Ironman-007/SensorNet_Host/Reference/PCB/nets_v2.brd

## EAGLE design Reference/PCB/nets_v2.brd (2024-06-01)

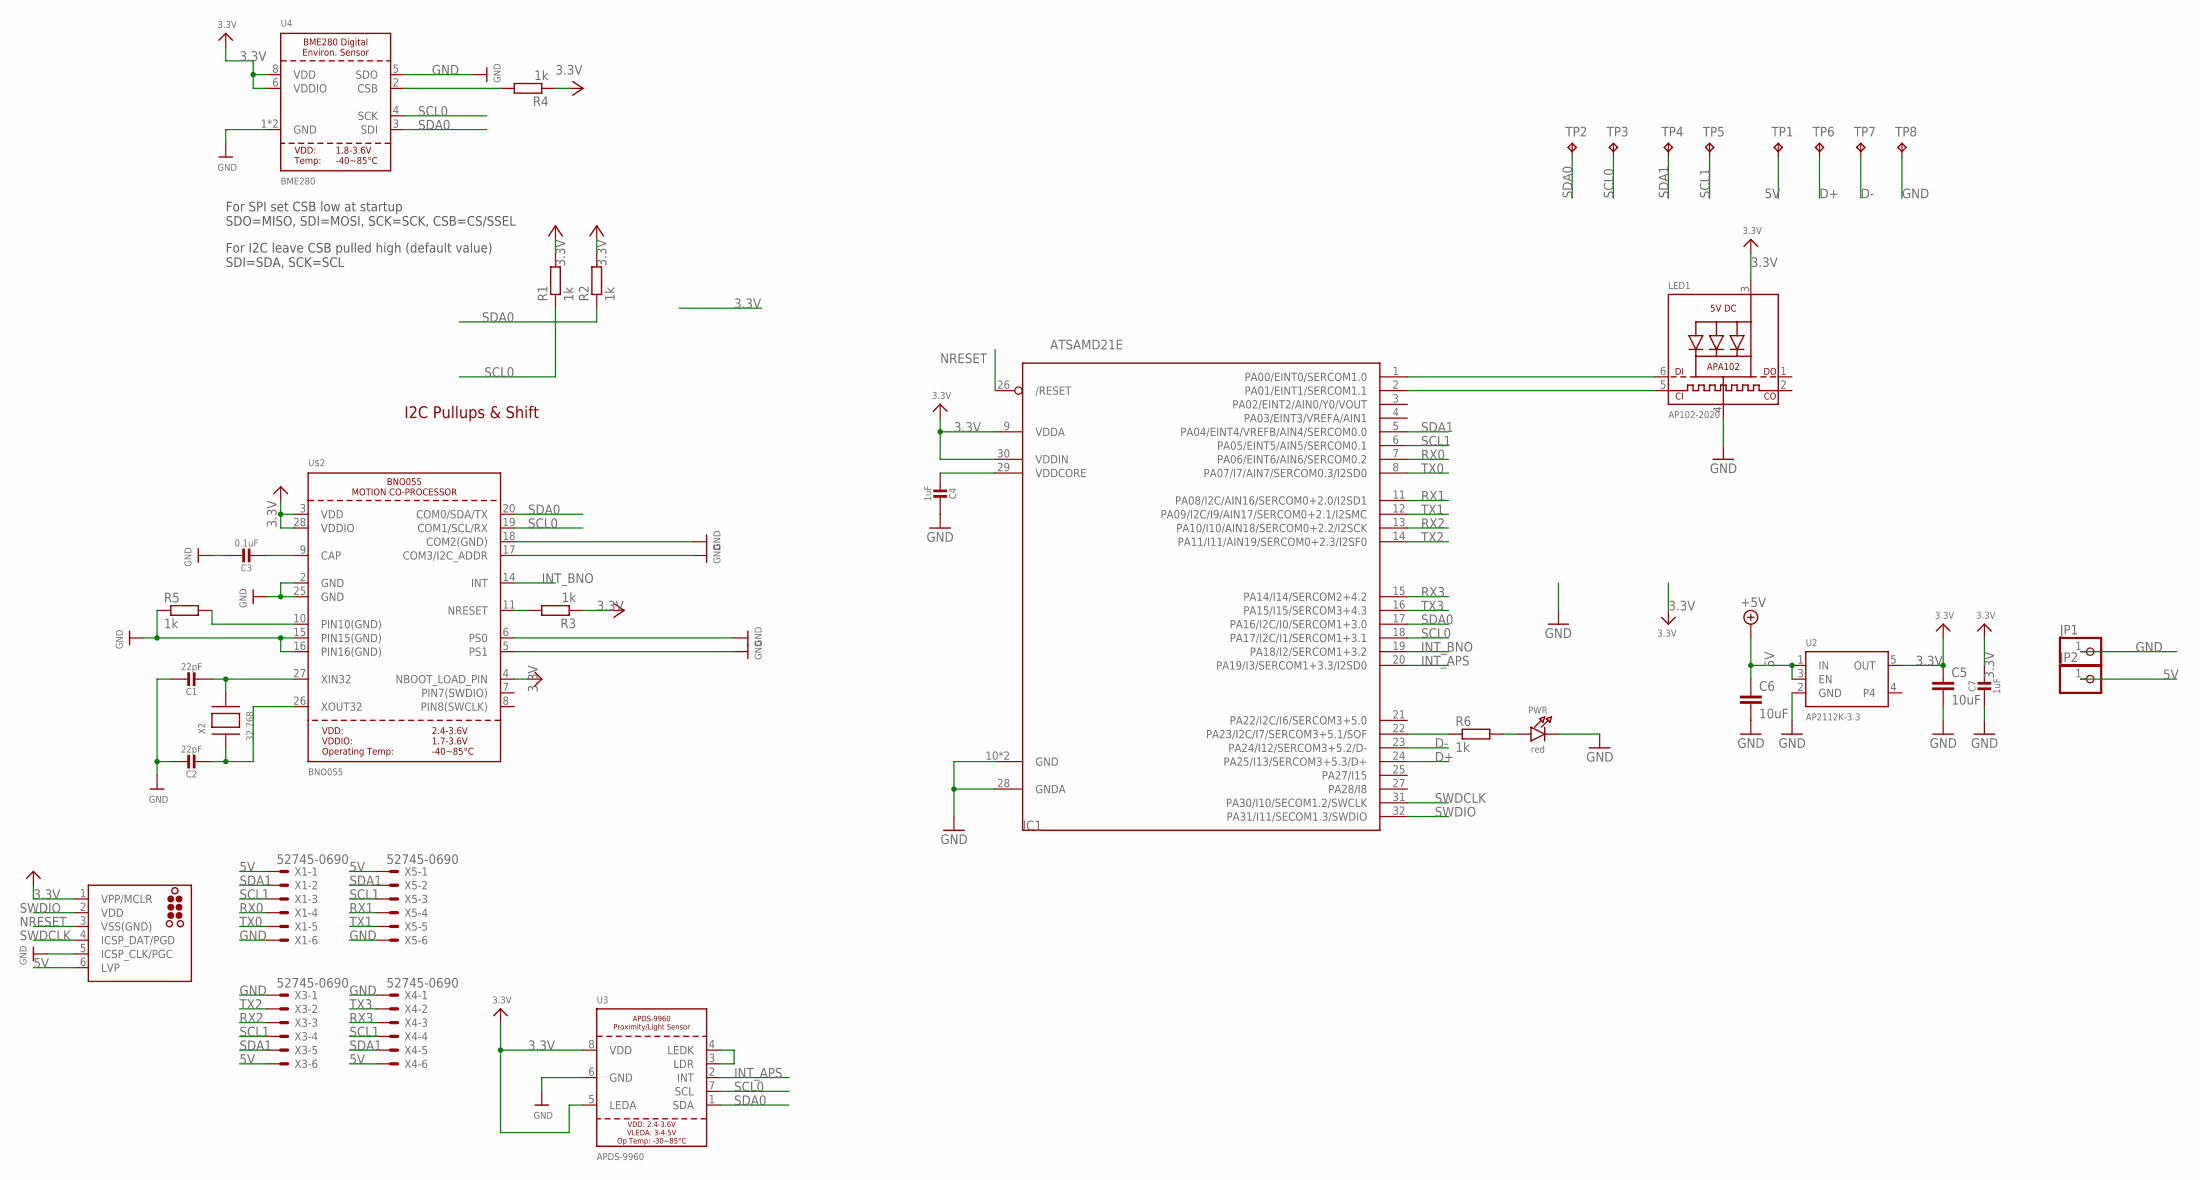
[picture p1: schematic nets_v2.sch]

Parts:
C1, C2: 22pF; _0402NO; MPN 885012005042
C3: 0.1uF; _0402NO; MPN R79IC3100Z340J
C4, C7: 1uF; _0402NO
C5, C6: 10uF; C0603
IC1: ATSAMD21E; QFN32_5MM
J1: TC2030-ICSP-MCP-NL; TC2030-MCP-NL
JP1, JP2: PINHD-1X1; 1X01
LED1: AP102-2020; APA102_2020
PWR: red; CHIPLED_0603_NOOUTLINE
R1, R2, R3, R4, R5, R6: 1k; R0402
TP1, TP2, TP3, TP4, TP5, TP6, TP7, TP8: TPTP10R; TP10R
U2: AP2112K-3.3; SOT23-5
U3: APDS-9960
U4: BME280
U$2: BNO055
X1, X3, X4, X5: 52745-0690
X2: 32.768; XTAL3215

Connections:
3.3V: C5.1, C7.1, IC1.9 (VDDA), IC1.30 (VDDIN), J1.1 (VPP/MCLR), LED1.3 (VDD), R1.2, R2.2, R3.1, R4.1, U2.5 (OUT), U3.5 (LEDA), U3.8 (VDD), U4.6 (VDDIO), U4.8 (VDD), U$2.3 (VDD), U$2.4 (NBOOT_LOAD_PIN), U$2.28 (VDDIO)
5V: C6.1, J1.6 (LVP), JP2.1, TP1.TP, U2.1 (IN), U2.3 (EN), X1.1, X3.6, X4.6, X5.1
D+: IC1.24 (PA25/I13/SERCOM3+5.3/D+), TP6.TP
D-: IC1.23 (PA24/I12/SERCOM3+5.2/D-), TP7.TP
GND: C1.1, C2.1, C3.1, C4.1, C5.2, C6.2, C7.2, IC1.10 (GND), IC1.28 (GNDA), IC1.33 (GND), J1.5 (ICSP_CLK/PGC), JP1.1, LED1.4 (GND), PWR.C, R5.1, TP8.TP, U2.2 (GND), U3.6 (GND), U4.1 (GND), U4.5 (SDO), U4.7 (GND), U$2.2 (GND), U$2.5 (PS1), U$2.6 (PS0), U$2.15 (PIN15(GND)), U$2.16 (PIN16(GND)), U$2.17 (COM3/I2C_ADDR), U$2.18 (COM2(GND)), U$2.25 (GND), X1.6, X3.1, X4.1, X5.6
INT_APS: IC1.20 (PA19/I3/SERCOM1+3.3/I2SD0), U3.2 (INT)
INT_BNO: IC1.19 (PA18/I2/SERCOM1+3.2), U$2.14 (INT)
unnamed: C1.2, U$2.27 (XIN32), X2.P$2
unnamed: C2.2, U$2.26 (XOUT32), X2.P$1
unnamed: C3.2, U$2.9 (CAP)
unnamed: PWR.A, R6.2
unnamed: U3.3 (LDR), U3.4 (LEDK)
unnamed: R5.2, U$2.10 (PIN10(GND))
unnamed: R3.2, U$2.11 (NRESET)
unnamed: R4.2, U4.2 (CSB)
unnamed: IC1.1 (PA00/EINT0/SERCOM1.0), LED1.6 (DI)
unnamed: IC1.22 (PA23/I2C/I7/SERCOM3+5.1/SOF), R6.1
unnamed: IC1.2 (PA01/EINT1/SERCOM1.1), LED1.5 (CKI)
NRESET: IC1.26 (/RESET), J1.3 (VSS(GND))
RX0: IC1.7 (PA06/EINT6/AIN6/SERCOM0.2), X1.4
RX1: IC1.11 (PA08/I2C/AIN16/SERCOM0+2.0/I2SD1), X5.4
RX2: IC1.13 (PA10/I10/AIN18/SERCOM0+2.2/I2SCK), X3.3
RX3: IC1.15 (PA14/I14/SERCOM2+4.2), X4.3
SCL0: IC1.18 (PA17/I2C/I1/SERCOM1+3.1), R1.1, TP3.TP, U3.7 (SCL), U4.4 (SCK), U$2.19 (COM1/SCL/RX)
SCL1: IC1.6 (PA05/EINT5/AIN5/SERCOM0.1), TP5.TP, X1.3, X3.4, X4.4, X5.3
SDA0: IC1.17 (PA16/I2C/I0/SERCOM1+3.0), R2.1, TP2.TP, U3.1 (SDA), U4.3 (SDI), U$2.20 (COM0/SDA/TX)
SDA1: IC1.5 (PA04/EINT4/VREFB/AIN4/SERCOM0.0), TP4.TP, X1.2, X3.5, X4.5, X5.2
SWDCLK: IC1.31 (PA30/I10/SECOM1.2/SWCLK), J1.4 (ICSP_DAT/PGD)
SWDIO: IC1.32 (PA31/I11/SECOM1.3/SWDIO), J1.2 (VDD)
TX0: IC1.8 (PA07/I7/AIN7/SERCOM0.3/I2SD0), X1.5
TX1: IC1.12 (PA09/I2C/I9/AIN17/SERCOM0+2.1/I2SMC), X5.5
TX2: IC1.14 (PA11/I11/AIN19/SERCOM0+2.3/I2SF0), X3.2
TX3: IC1.16 (PA15/I15/SERCOM3+4.3), X4.2
VDDCORE: C4.2, IC1.29 (VDDCORE)

Notes on the sheet:
I2C Pullups & Shift
For SPI set CSB low at startup SDO=MISO, SDI=MOSI, SCK=SCK, CSB=CS/SSEL
For I2C leave CSB pulled high (default value) SDI=SDA, SCK=SCL

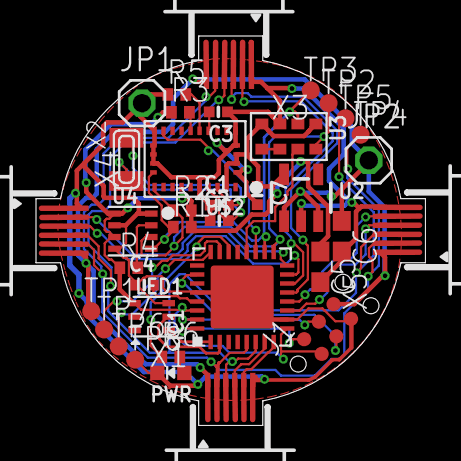
[picture p2: board nets_v2.brd from above]

Board: 2 copper layers, 21.6 x 21.6 mm, 36 parts (0 on the bottom side), 34 nets.
