Ironman-007/SensorNet_Host/Reference/PCB/nets_v3_mastersmall.brd

## EAGLE design Reference/PCB/nets_v3_mastersmall.brd (2024-06-01)

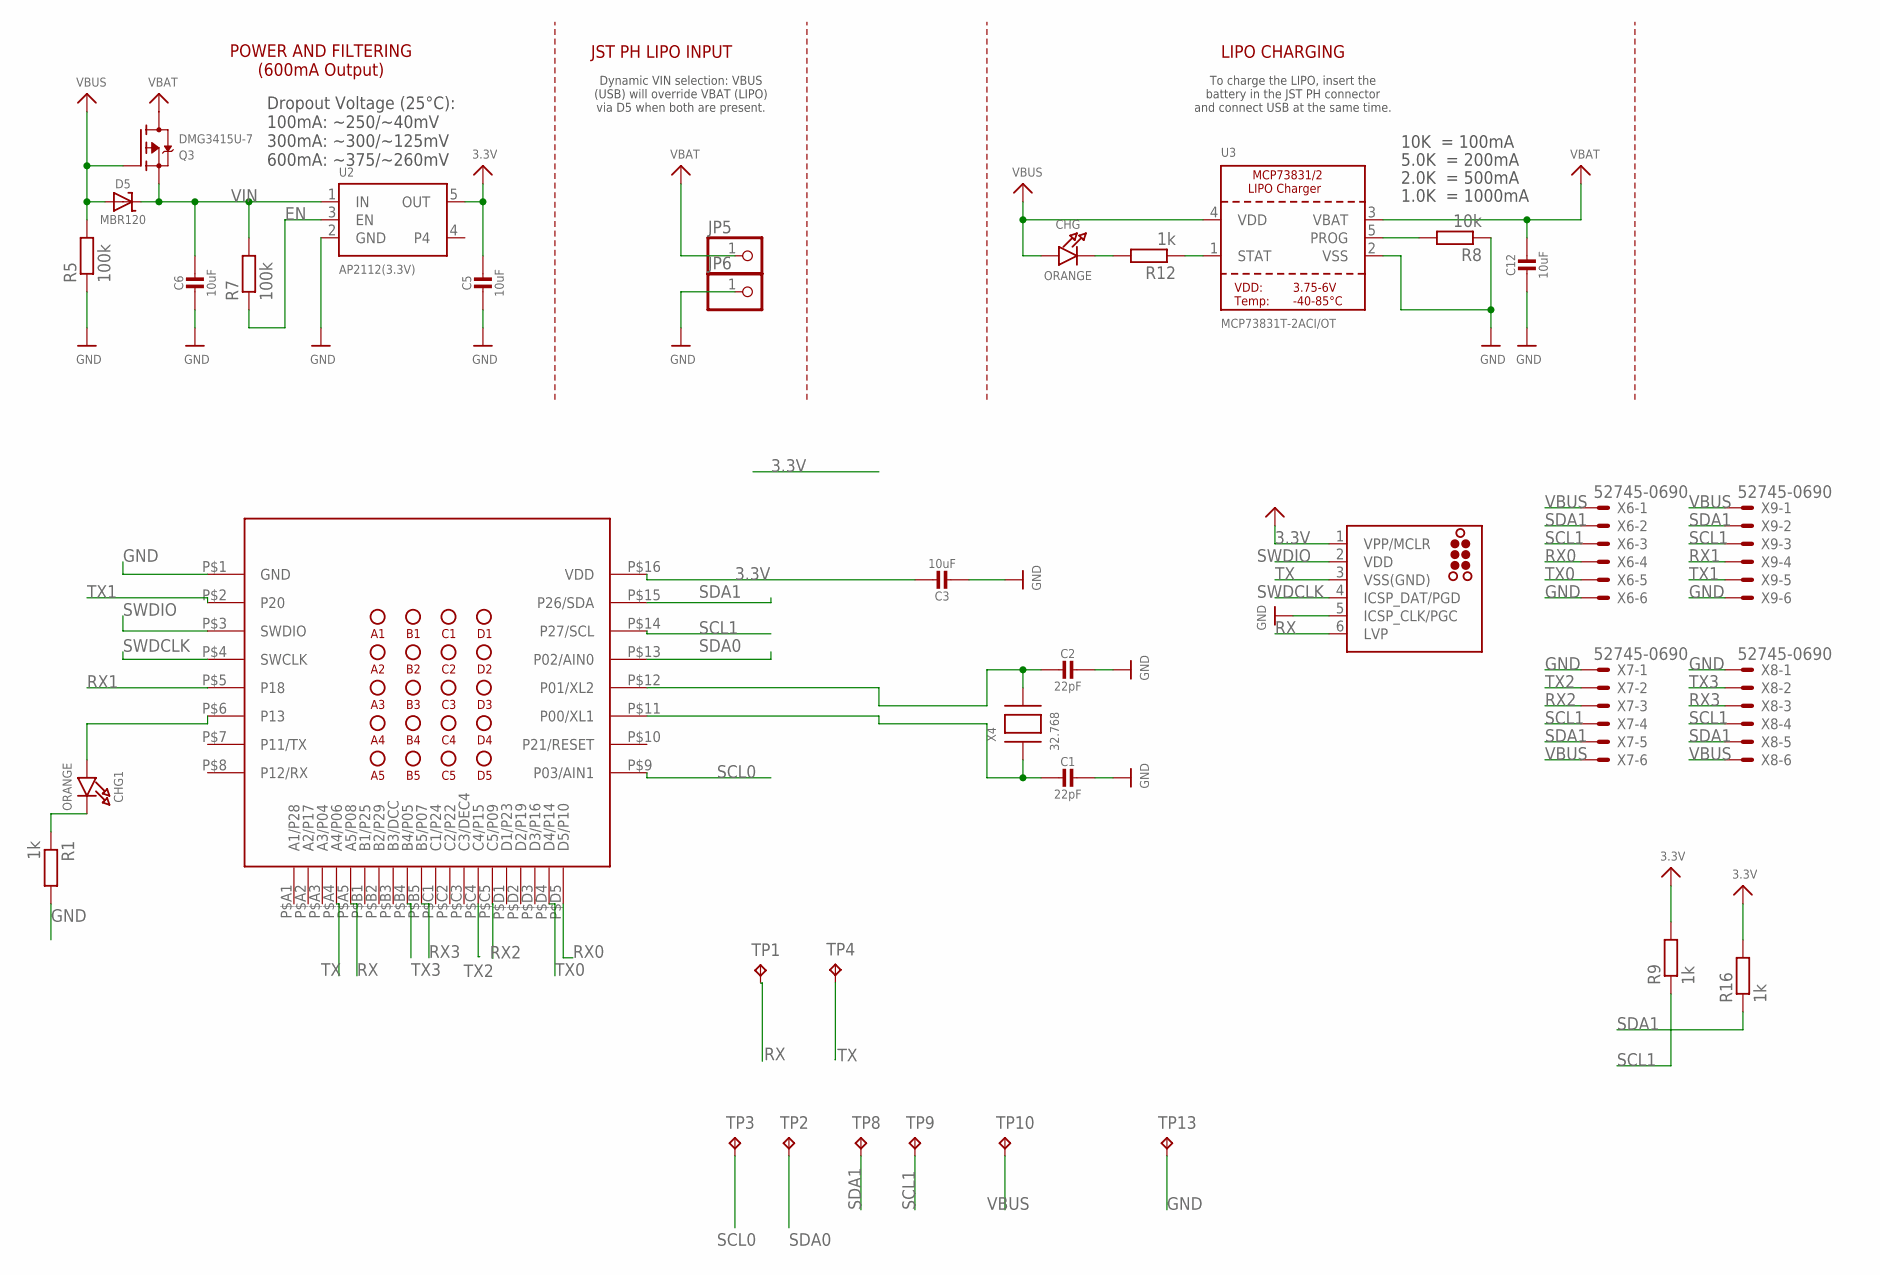
[picture p3: schematic nets_v3_mastersmall.sch]

Parts:
C1, C2: 22pF; _0402NO; MPN 885012005042
C3, C5, C6, C12: 10uF; 0603-NO
CHG, CHG1: ORANGE; CHIPLED_0805_NOOUTLINE
D5: MBR120; SOD-123
J1: TC2030-ICSP-MCP-NL; TC2030-MCP-NL
JP5, JP6: PINHD-1X1; 1X01
Q3: DMG3415U-7; SOT23-R
R1, R9, R12, R16: 1k; R0402
R5, R7: 100k; R0402
R8: 10k; R0402
TP1, TP2, TP3, TP4, TP8, TP9, TP10, TP13: TPTP10R; TP10R
U1: BC832-V1; BC832
U2: AP2112(3.3V); SOT23-5
U3: MCP73831T-2ACI/OT; SOT23-5
X4: 32.768; XTAL3215
X6, X7, X8, X9: 52745-0690

Connections:
3.3V: C3.1, C5.1, J1.1 (VPP/MCLR), R9.2, R16.2, U1.P$16 (VDD), U2.5 (OUT)
EN: R7.1, U2.3 (EN)
GND: C1.1, C2.1, C3.2, C5.2, C6.2, C12.2, J1.5 (ICSP_CLK/PGC), JP6.1, R1.2, R5.1, R8.1, TP13.TP, U1.P$1 (GND), U2.2 (GND), U3.2 (VSS), X6.6, X7.1, X8.1, X9.6
unnamed: CHG.C, R12.2
unnamed: C1.2, U1.P$11 (P00/XL1), X4.P$1
unnamed: CHG1.A, U1.P$6 (P13)
unnamed: CHG1.C, R1.1
unnamed: C2.2, U1.P$12 (P01/XL2), X4.P$2
unnamed: R12.1, U3.1 (STAT)
unnamed: R8.2, U3.5 (PROG)
RX: J1.6 (LVP), TP1.TP, U1.P$A5 (A5/P08)
RX0: U1.P$D5 (D5/P10), X6.4
RX1: U1.P$5 (P18), X9.4
RX2: U1.P$C5 (C5/P09), X7.3
RX3: U1.P$B5 (B5/P07), X8.3
SCL0: TP3.TP, U1.P$9 (P03/AIN1)
SCL1: R9.1, TP9.TP, U1.P$14 (P27/SCL), X6.3, X7.4, X8.4, X9.3
SDA0: TP2.TP, U1.P$13 (P02/AIN0)
SDA1: R16.1, TP8.TP, U1.P$15 (P26/SDA), X6.2, X7.5, X8.5, X9.2
SWDCLK: J1.4 (ICSP_DAT/PGD), U1.P$4 (SWCLK)
SWDIO: J1.2 (VDD), U1.P$3 (SWDIO)
TX: J1.3 (VSS(GND)), TP4.TP, U1.P$A4 (A4/P06)
TX0: U1.P$D4 (D4/P14), X6.5
TX1: U1.P$2 (P20), X9.5
TX2: U1.P$C4 (C4/P15), X7.2
TX3: U1.P$B4 (B4/P05), X8.2
VBAT: C12.1, JP5.1, Q3.3 (D), U3.3 (VBAT)
VBUS: CHG.A, D5.A, Q3.1 (G), R5.2, TP10.TP, U3.4 (VDD), X6.1, X7.6, X8.6, X9.1
VIN: C6.1, D5.C, Q3.2 (S), R7.2, U2.1 (IN)

Notes on the sheet:
10K = 100mA
5.0K = 200mA
2.0K = 500mA
1.0K = 1000mA
LIPO CHARGING
To charge the LIPO, insert the battery in the JST PH connector and connect USB at the same time.
POWER AND FILTERING (600mA Output)
JST PH LIPO INPUT
Dynamic VIN selection: VBUS (USB) will override VBAT (LIPO) via D5 when both are present.
Dropout Voltage (25°C): 100mA: ~250/~40mV 300mA: ~300/~125mV 600mA: ~375/~260mV

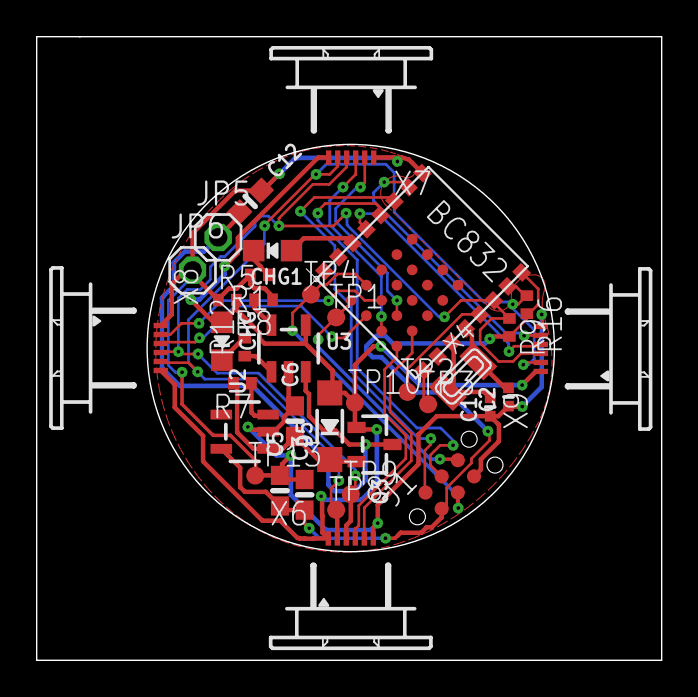
[picture p4: board nets_v3_mastersmall.brd from above]

Board: 2 copper layers, 34.7 x 34.6 mm, 36 parts (0 on the bottom side), 29 nets.
