Ironman-007/SensorNet_Host/(commit log)

2024-06-01 udated by FZ
    [nets_v2.brd, nets_v2.sch, nets_v3_mastersmall.brd, nets_v3_mastersmall.sch]
2024-06-01 udated by FZ: BLE send data working
    [nets_v2.brd, nets_v2.sch, nets_v3_mastersmall.brd, nets_v3_mastersmall.sch]
2024-06-03 udated by FZ: added reading sensor network, to be tested.
2024-06-03 udated by FZ: why the I2C scan is not working?.
    [SN_host_node_FZ.cpp, main.cpp]
2024-06-03 udated by FZ: solve I2C problem, to be tested the reading data from nodes.
    [SN_host_node_FZ.cpp, main.cpp]
2024-06-04 udated by FZ: add node number to the data frame (first two bytes).
